lukavidic/Vihor/docs/images/joycar.jpeg

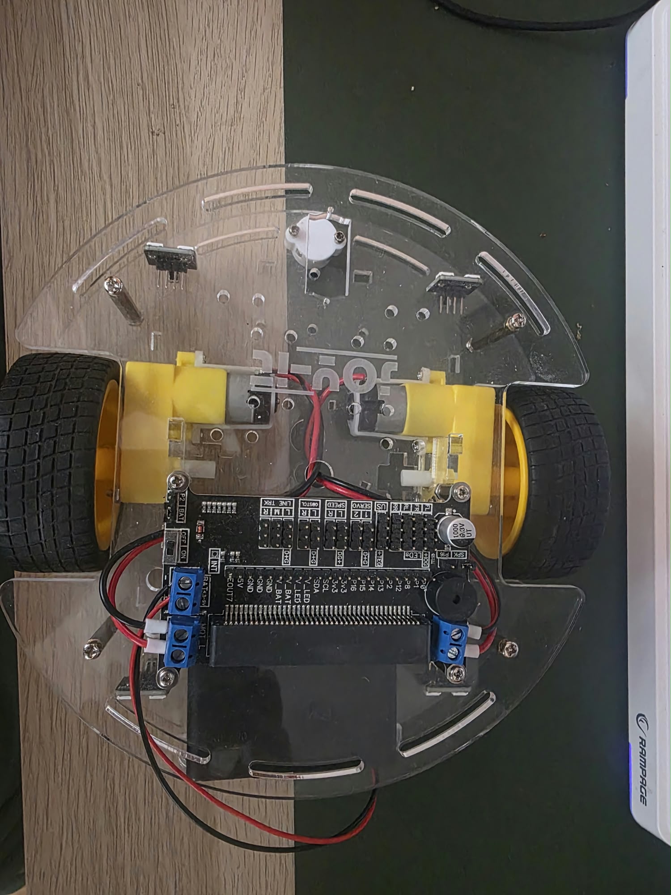
docs/images/joycar.jpeg
