lukavidic/Vihor/hardware/Vihor/Vihor.kicad_pcb

## KiCad design Schematic/RX/RX.kicad_sch


Parts:
A1: Arduino_Uno_R4_WiFi_Shield
U1: L293D; DIP880W50P254L2000H510Q16
U2: HC-SR04_Ultrasonic_Sensor
U3, U4: (no value)

Connections:
unnamed: A1.5V1 (5V), U2.1 (VCC)
unnamed: A1.D2, U1.2 (INPUT1)
unnamed: A1.D3, U1.1 (ENABLE1)
unnamed: A1.D4, U1.7 (INPUT2)
unnamed: A1.D5, U1.10 (INPUT3)
unnamed: A1.D6, U1.9 (ENABLE2)
unnamed: A1.D7, U1.15 (INPUT4)
unnamed: A1.D8, U2.3 (ECHO)
unnamed: A1.D9, U2.2 (TRIG)
unnamed: A1.GND2 (GND), U2.4 (GND)
unnamed: A1.GND3 (GND), U1.4 (GND), U1.5 (GND), U1.12 (GND), U1.13 (GND)
unnamed: U1.3 (OUTPUT1), U3.
unnamed: U1.6 (OUTPUT2), U3.
unnamed: U1.11 (OUTPUT3), U4.
unnamed: U1.14 (OUTPUT4), U4.
VIN: U1.8 (VS), U1.16 (VSS)
