lukavidic/Vihor/(commit log)

2026-11-03 Azurirana specifikacija zahtjeva (v0.4)
    - Uklonjena okretna kula i servo, sve je fiksno na vozilu
    - Dva fiksna ToF senzora: nisko za prepreke, na visini mete za metu
    - Dvije mašine stanja (vozilo i meta/top), izbjegavanje prepreke ima prioritet
2026-11-04 Dodan JoyCar I2C interfejs, ažurirani pinovi i napajanje
2026-11-10 Dodana kula, servo na RB14, odjeljak 8 (v0.9)
2026-11-10 Dodana kula, servo na RB14 (v0.3)
2026-11-11 Servo SG90 (v0.4)
2026-11-11 Dodan servo SG90 (v0.4)
2026-11-11 Dodan servo SG90
2026-11-11 Interfejs v0.10: servo SG90
2026-11-11 KiCad projekat, biblioteke i prazni listovi
    [Vihor.kicad_pcb, Vihor.kicad_sch, edge.kicad_sch, mcu.kicad_sch, sensors_top.kicad_sch, wifi.kicad_sch]
2026-11-11 Edge lista: ivicni konektor J3 i signali
    [edge.kicad_sch, mcu.kicad_sch]
2026-11-12 WiFi list: ESP-01, UART, pull-upovi
    [edge.kicad_sch, mcu.kicad_sch, wifi.kicad_sch]
2026-11-12 Dodan jos jedna kondenzator
    [wifi.kicad_sch]
2026-11-12 Senzori i top: IR konektor, konektor topa i mjerenje napona
    [sensors_top.kicad_sch]
2026-11-12 ERC, TBD napomene i naslov
    [Vihor.kicad_sch, edge.kicad_sch, mcu.kicad_sch, sensors_top.kicad_sch, wifi.kicad_sch]
2026-11-12 7. Praćenje” je postalo “6. Praćenje
2026-11-12 KiCad 10, konektori J1 do J5, nova šema (odjeljak 9), dvije nove provjere na prototipu
2026-11-12 Tabela dijelova sa šeme, IR modul Potvrđeno, slika baterije baterija-aa.jpg, bez linkova za slike koje ne postoje (JoyCar, top, PCB)
2026-11-13 Dodani pull-down otpornici i ESP_RST
    [edge.kicad_sch, mcu.kicad_sch, sensors_top.kicad_sch, wifi.kicad_sch]
